Piter-d/PCB_CNC/3D/support roulement.stl

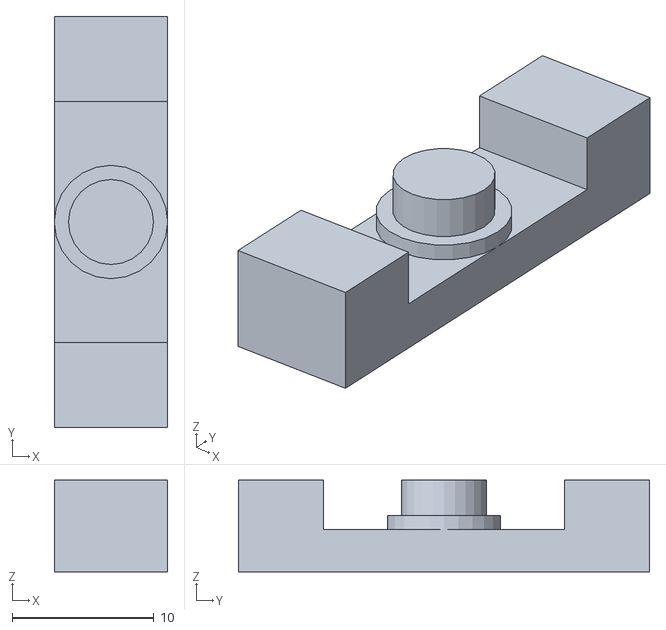
[picture p18: CAD file, 2020-12-27]
3D/support roulement.stl
8.00 x 29.0 x 6.49
