Piter-d/PCB_CNC/3D/glissiere.stl

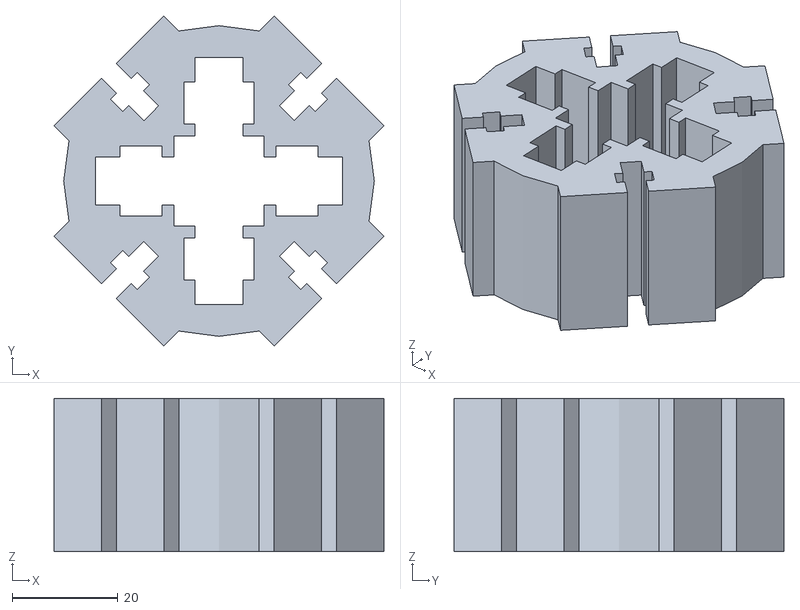
[picture p19: CAD file, 2020-12-27]
3D/glissiere.stl
62.4 x 62.4 x 29.0
